benjaminandrew-ee/battery-monitoring-system/hardware/Battery_Monitor.kicad_sch

## KiCad design hardware/Battery_Monitor.kicad_sch (2026-11-08)

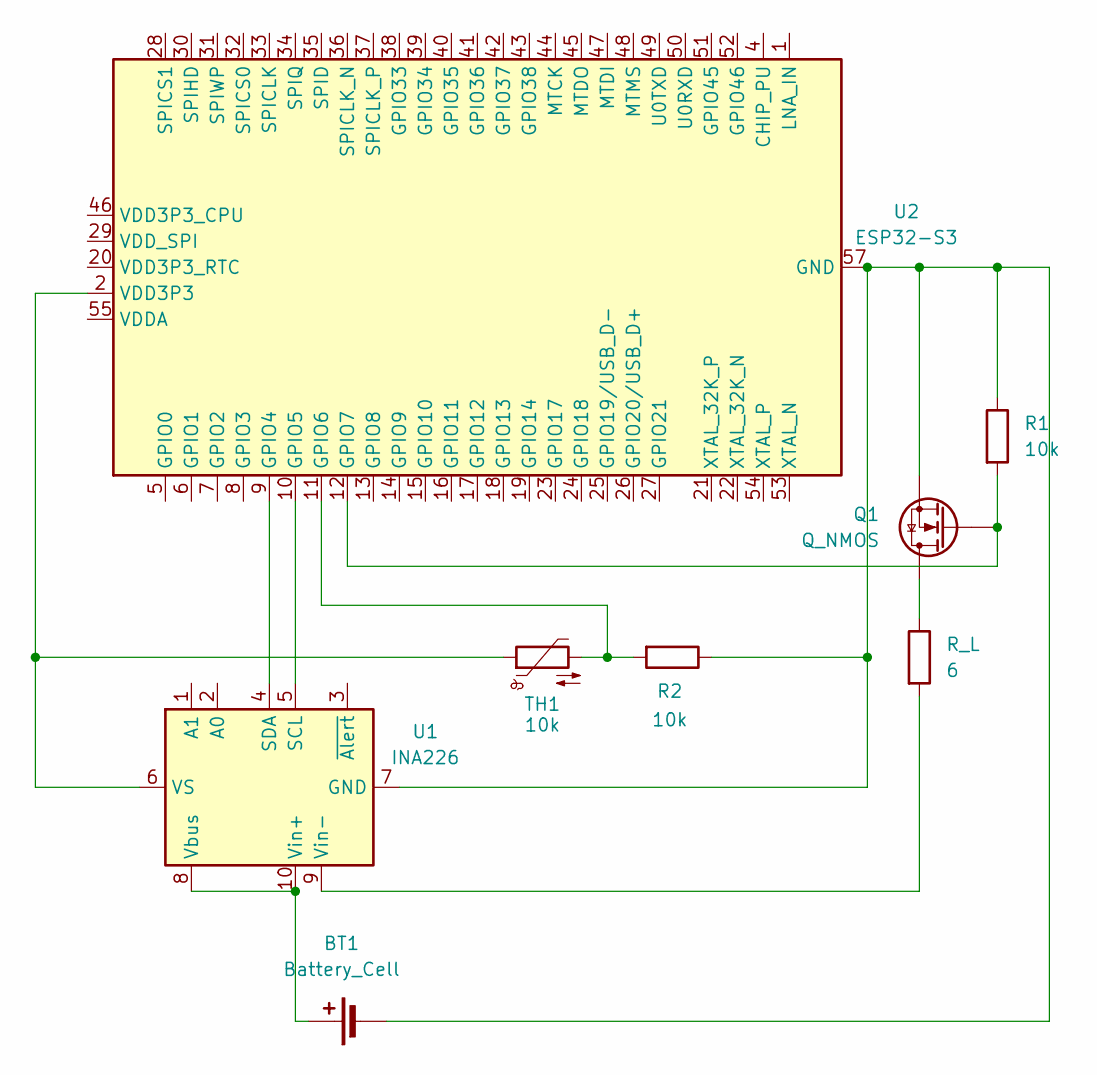
[picture p1: schematic Battery_Monitor.kicad_sch]

Parts:
BT1: Battery_Cell
Q1: Q_NMOS
R1, R2: 10k
R_L: 6
TH1: 10k
U1: INA226; TSSOP-10_3x3mm_P0.5mm
U2: ESP32-S3; QFN-56-1EP_7x7mm_P0.4mm_EP4x4mm

Connections:
unnamed: BT1.1 (+), U1.8 (Vbus), U1.10 (Vin+)
unnamed: BT1.2 (-), Q1.S, R1.1, R2.1, U1.7 (GND), U2.57 (GND)
unnamed: Q1.D, R_L.1
unnamed: Q1.G, R1.2, U2.12 (GPIO7)
unnamed: R2.2, TH1.2, U2.11 (GPIO6)
unnamed: R_L.2, U1.9 (Vin-)
unnamed: TH1.1, U1.6 (VS), U2.2 (VDD3P3), U2.3 (VDD3P3)
unnamed: U1.4 (SDA), U2.9 (GPIO4)
unnamed: U1.5 (SCL), U2.10 (GPIO5)
unnamed: U2.55 (VDDA), U2.56 (VDDA)
